MakerLabsVan/BarBot/Test_code/Port_Communication/Serial_communication/Button_control.ino

const int buttonPin = 10;     // the number of the pushbutton pin
const int ledPin =  13;      // the number of the LED pin

// variables will change:
int buttonState = 0;         // variable for reading the pushbutton status

void setup() {
  // initialize the LED pin as an output:
  pinMode(ledPin, OUTPUT);
  // initialize the pushbutton pin as an input:
  pinMode(buttonPin, INPUT);
  Serial.begin(9600);
}

void loop() {
  // read the state of the pushbutton value:
  buttonState = digitalRead(buttonPin);

  // check if the pushbutton is pressed.
  // if it is, the buttonState is HIGH:
  if (buttonState == HIGH) {
    delay(100);
    if (buttonState == HIGH) {
      digitalWrite(ledPin, HIGH);
      Serial.println("E");
      delay(1000);
    }
  } else {
    // turn LED off:
    digitalWrite(ledPin, LOW);
  }
}
