MakerLabsVan/BarBot/(commit log)

2016-11-01 Basic Serial Communications between BarBot and Arduino. Controlling LED is possible!
2016-11-10 Add stirring and LED indication features
2016-11-11 Button feature and new arrangement for files
2016-11-28 Integrate LED and Stirrer, minor changes to the script
